eslamdyab21/BI-Modes-Robot/README.md

# BI-Modes-Robot
We are team 16 and in this repository, we put the Hardware Project of the Microprocessors Course taught at EEE Department, Faculty of Engineering, Alexandria University.

In this project, we built a BI-Model Robot that can be controlled via a mobile application through Wi-Fi, or can operate as a self-driving car that can avoid obstacles.
<br>Video for explaing and testing: https://drive.google.com/file/d/1xyzm_IeHu87bhdZDyzJcZJ7ma5Ln9Ej0/view 
<br>More details on the components used will be in the report.
