eslamdyab21/BI-Modes-Robot/Schematic.png

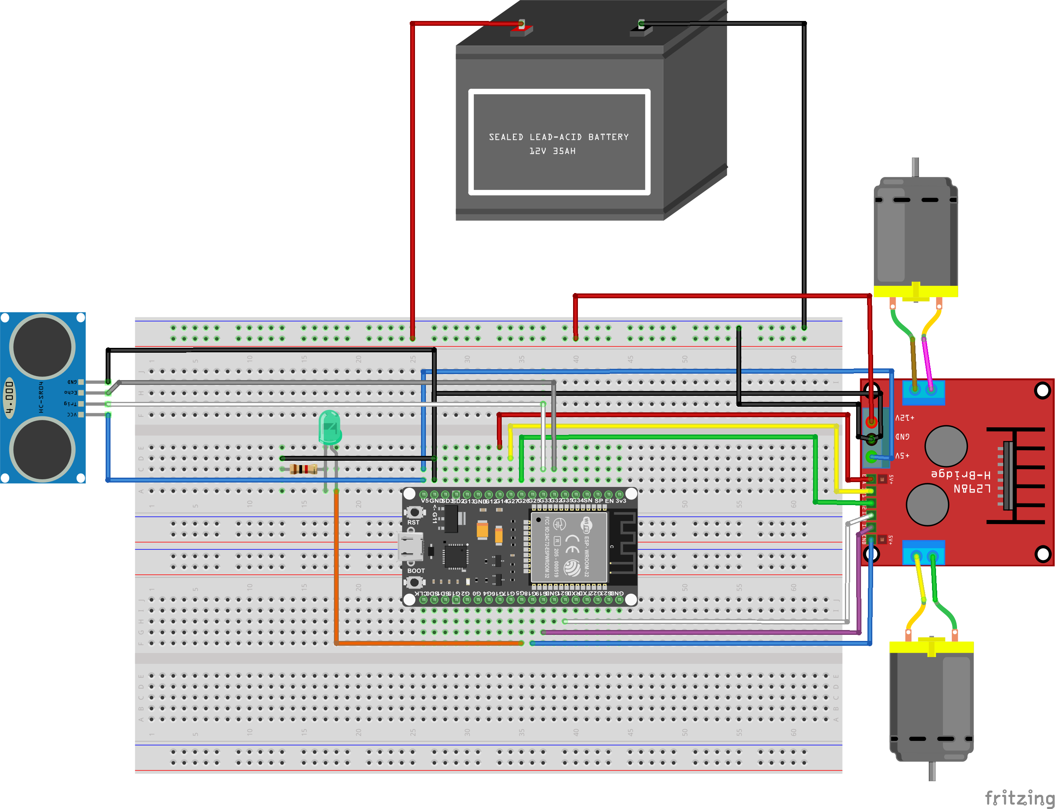
Schematic.png
